SHC-ASTRA/ASTRA_Ground_Station_Electronics/Ground_Station_Electronics/Ground_Station_Electronics.kicad_pcb

## KiCad design Ground_Station_Electronics/Ground_Station_Electronics.kicad_pcb (2022-04-20)

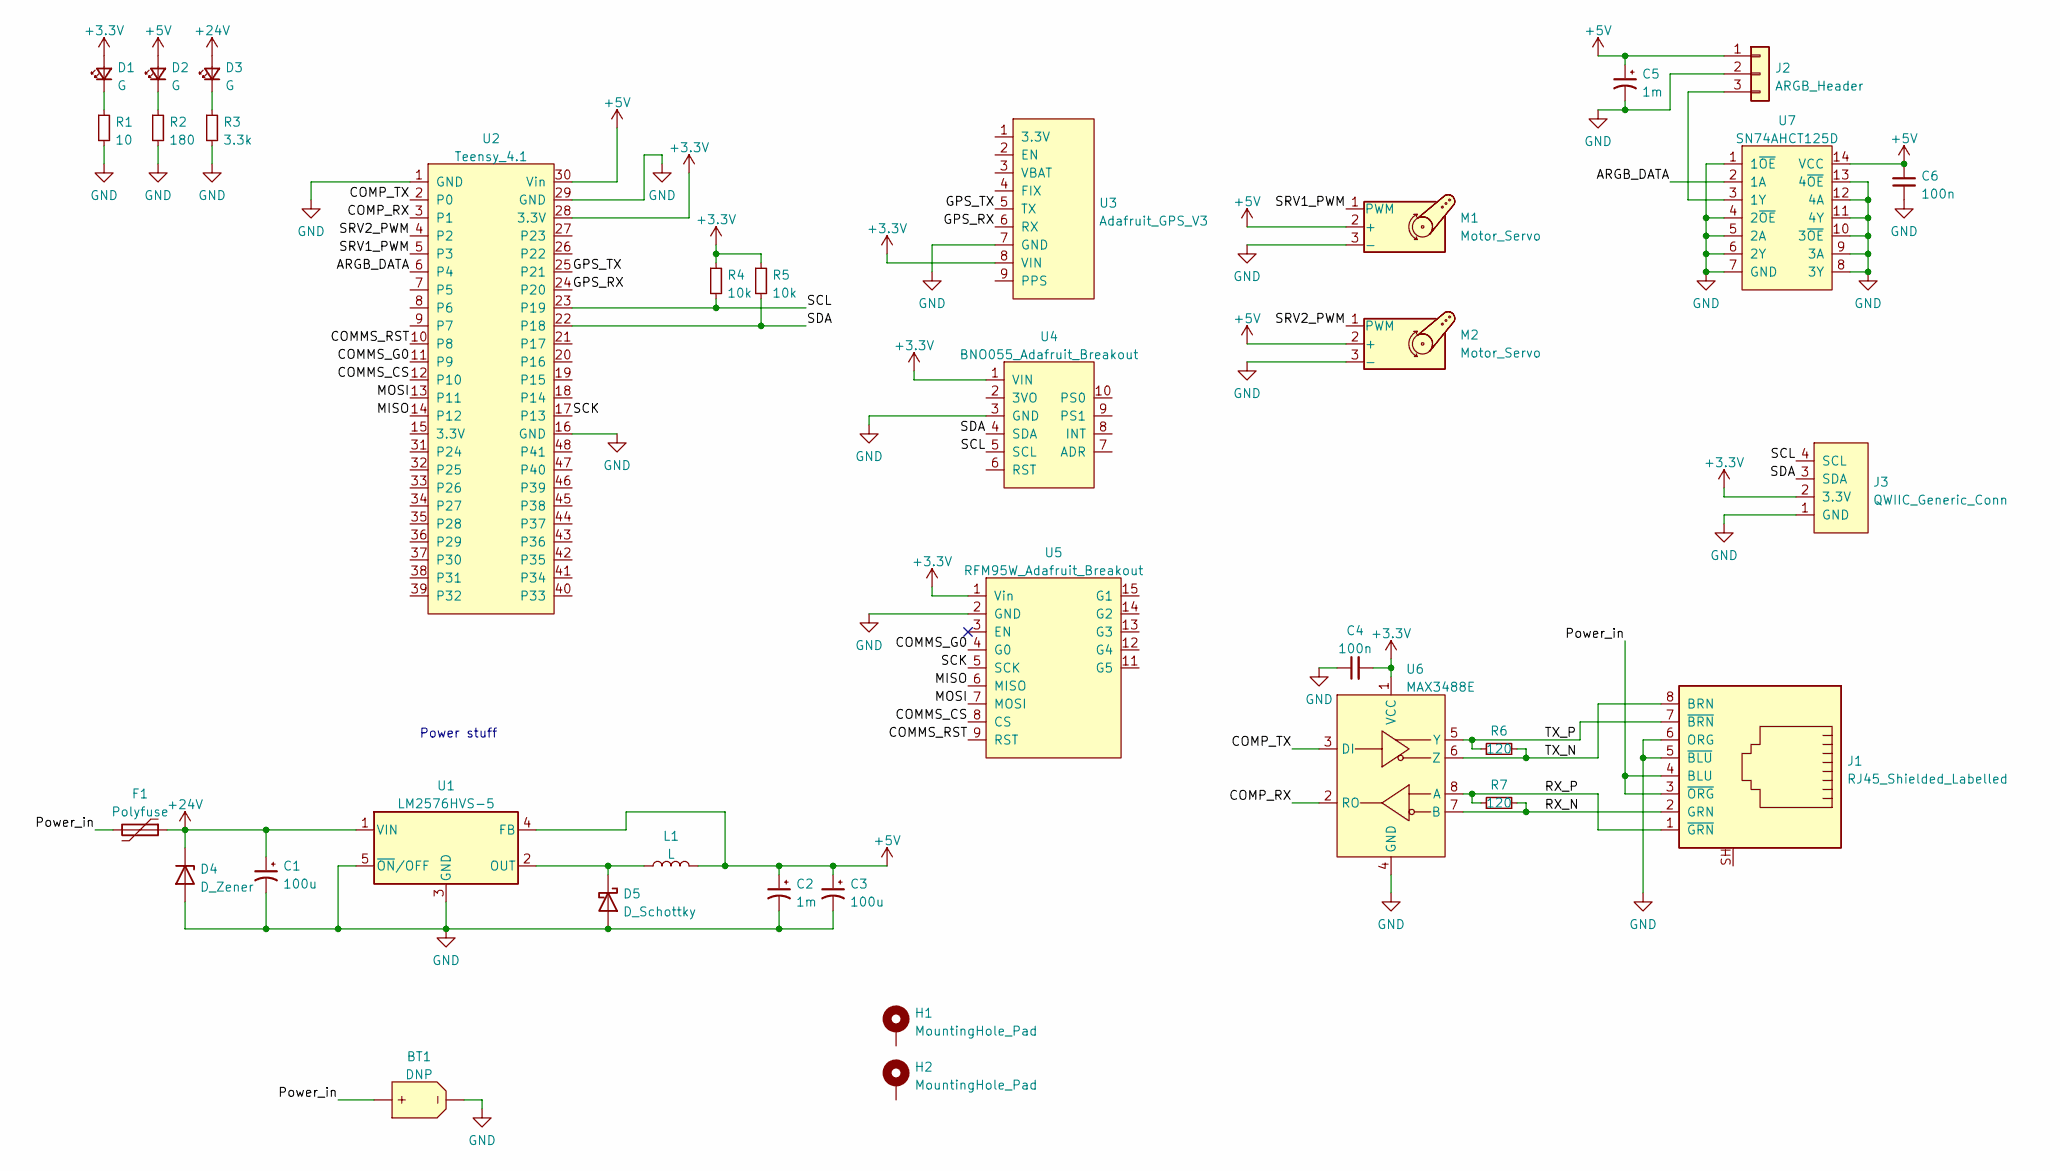
[picture p1: schematic Ground_Station_Electronics.kicad_sch]

Parts:
BT1: DNP; AMASS_XT30U-M_1x02_P5.0mm_Vertical
C1, C3: 100u; CP_Elec_10x10; Digikey Part Num 50PEV100M10X10.5CT-ND
C2, C5: 1m; C_Radial_D10.0mm_H12.5mm_P5.00mm; Digikey Part Num P16300-ND
C4, C6: 100n; C_0603_1608Metric
D1, D2, D3: G; LED_0603_1608Metric_Pad1.05x0.95mm_HandSolder; Digikey Part Num 732-4971-1-ND
D4: D_Zener; D_SMB_Handsoldering; Digikey Part Num 1655-SMBJ36ACT-ND
D5: D_Schottky; D_SMC_Handsoldering; Digikey Part Num B560C-FDICT-ND
F1: Polyfuse; Fuse_2920_7451Metric_Pad2.10x5.45mm_HandSolder; Digikey Part Num 507-1747-1-ND
H1, H2: MountingHole_Pad; MountingHole_4.3mm_M4_Pad
J1: RJ45_Shielded_Labelled; RJ45_Amphenol_RJHSE5380; Digikey Part Num RJHSE5E80-ND
J2: ARGB_Header; JST_PH_B3B-PH-K_1x03_P2.00mm_Vertical
J3: QWIIC_Generic_Conn; JST_SH_BM04B-SRSS-TB_1x04-1MP_P1.00mm_Vertical
L1: L; L_Wuerth_HCF-2920; Digikey Part Num 732-11715-ND
M1, M2: Motor_Servo; PinHeader_1x03_P2.54mm_Vertical
R1: 10; R_0603_1608Metric; Digikey Part Num 311-10.0HRCT-ND
R2: 180; R_0603_1608Metric; Digikey Part Num 311-180HRCT-ND
R3: 3.3k; R_0603_1608Metric; Digikey Part Num 311-3.30KHRCT-ND
R4, R5: 10k; R_0603_1608Metric
R6, R7: 120; R_0603_1608Metric; Digikey Part Num RMCF0603FT120RCT-ND
U1: LM2576HVS-5; TO-263-5_TabPin3; Digikey Part Num LM2576HVS-5.0/NOPB-ND
U2: Teensy_4.1; Teensy4.1; Digikey Part Num 1568-DEV-16996-ND
U3: Adafruit_GPS_V3; Adafruit_GPS_Breakout; Digikey Part Num 1528-1153-ND
U4: BNO055_Adafruit_Breakout; Adafruit_BNO055; Digikey Part Num 1528-4646-ND
U5: RFM95W_Adafruit_Breakout; Adafruit_RFM95W; Digikey Part Num 1528-1667-ND
U6: MAX3488E; SOIC-8_3.9x4.9mm_P1.27mm; Digikey Part Num MAX3488EESA+TCT-ND
U7: SN74AHCT125D; SOIC-14_3.9x8.7mm_P1.27mm; Digikey Part Num 296-4652-5-ND

Connections:
+3V3: C4.2, D1.2 (A), J3.2 (3.3V), R4.1, R5.1, U2.28 (3.3V), U3.8 (VIN), U4.1 (VIN), U5.1 (Vin), U6.1 (VCC)
+5V: C2.1, C3.1, C5.1, C6.2, D2.2 (A), J2.1, L1.2, M1.2 (+), M2.2 (+), U1.4 (FB), U2.30 (Vin), U7.14 (VCC)
+24V: C1.1, D3.2 (A), D4.1 (K), F1.1, U1.1 (VIN)
/ARGB_DATA: U2.6 (P4), U7.2 (1A)
/COMMS_CS: U2.12 (P10), U5.8 (CS)
/COMMS_G0: U2.11 (P9), U5.4 (G0)
/COMMS_RST: U2.10 (P8), U5.9 (RST)
/COMP_RX: U2.3 (P1), U6.2 (RO)
/COMP_TX: U2.2 (P0), U6.3 (DI)
/GPS_RX: U2.24 (P20), U3.6 (RX)
/GPS_TX: U2.25 (P21), U3.5 (TX)
/MISO: U2.14 (P12), U5.6 (MISO)
/MOSI: U2.13 (P11), U5.7 (MOSI)
/Power_in: BT1.2 (Pos), F1.2, J1.3 (~ORG), J1.4 (BLU)
/RX_N: J1.2 (GRN), R7.2, U6.7 (B)
/RX_P: J1.1 (~GRN), R7.1, U6.8 (A)
/SCK: U2.17 (P13), U5.5 (SCK)
/SCL: J3.4 (SCL), R4.2, U2.23 (P19), U4.5 (SCL)
/SDA: J3.3 (SDA), R5.2, U2.22 (P18), U4.4 (SDA)
/SRV1_PWM: M1.1 (PWM), U2.5 (P3)
/SRV2_PWM: M2.1 (PWM), U2.4 (P2)
/TX_N: J1.8 (BRN), R6.2, U6.6 (Z)
/TX_P: J1.7 (~BRN), R6.1, U6.5 (Y)
GND: BT1.1 (Neg), C1.2, C2.2, C3.2, C4.1, C5.2, C6.1, D4.2 (A), D5.2 (A), J1.5 (~BLU), J1.6 (ORG), J2.2, J3.1 (GND), M1.3 (-), M2.3 (-), R1.2, R2.2, R3.2, U1.3 (GND), U1.5 (~ON/OFF), U2.1 (GND), U2.16 (GND), U2.29 (GND), U3.7 (GND), U4.3 (GND), U5.2 (GND), U6.4 (GND), U7.1 (1~OE), U7.4 (2~OE), U7.5 (2A), U7.6 (2Y), U7.7 (GND), U7.8 (3Y), U7.9 (3A), U7.10 (3~OE), U7.11 (4Y), U7.12 (4A), U7.13 (4~OE)
unnamed: D1.1 (K), R1.1
unnamed: D2.1 (K), R2.1
unnamed: D3.1 (K), R3.1
unnamed: D5.1 (K), L1.1, U1.2 (OUT)
unnamed: J2.3, U7.3 (1Y)

Notes on the sheet:
Power stuff

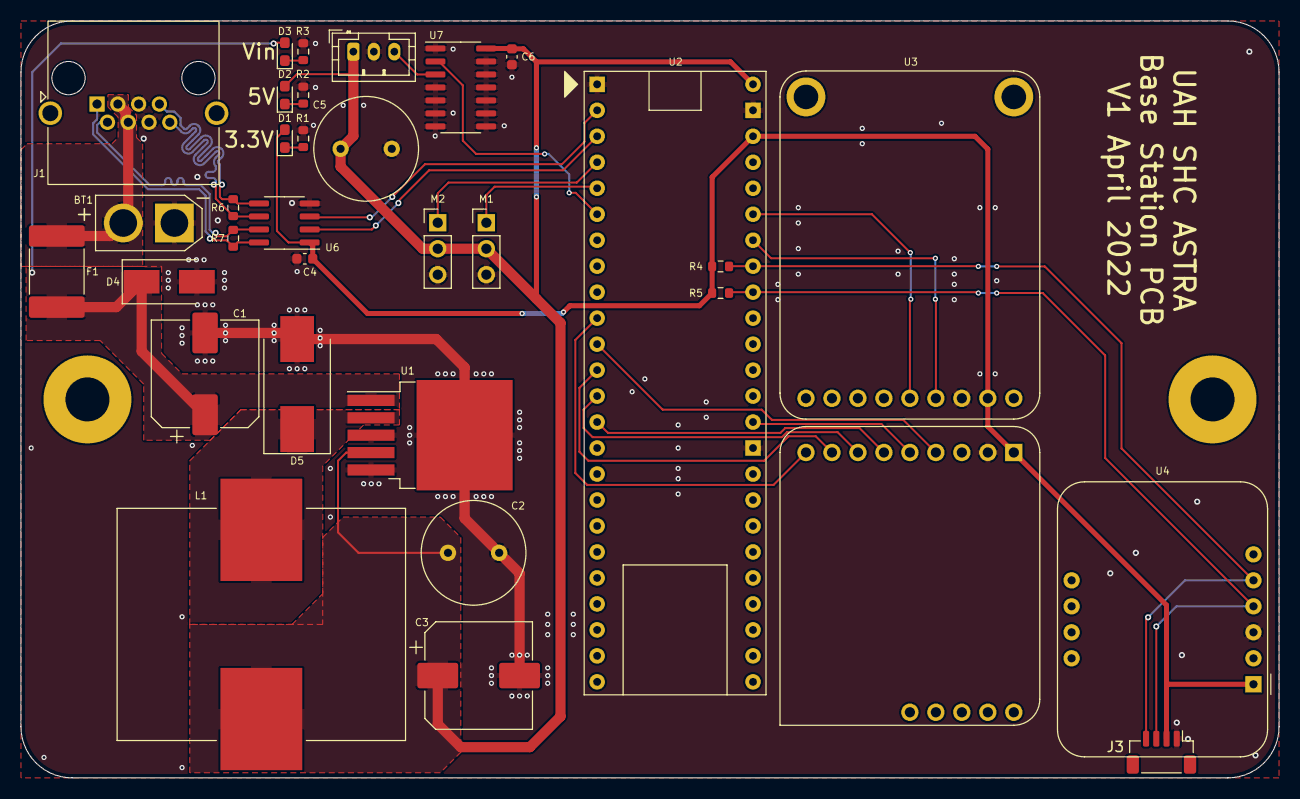
[picture p2: board Ground_Station_Electronics.kicad_pcb from above]

Board: 2 copper layers, 123.0 x 74.0 mm, 35 parts (0 on the bottom side), 29 nets.
