SHC-ASTRA/ASTRA_Ground_Station_Electronics/Ground_Station_Dongle/Ground_Station_Dongle.kicad_pcb

## KiCad design Ground_Station_Dongle/Ground_Station_Dongle.kicad_pcb (2022-04-20)

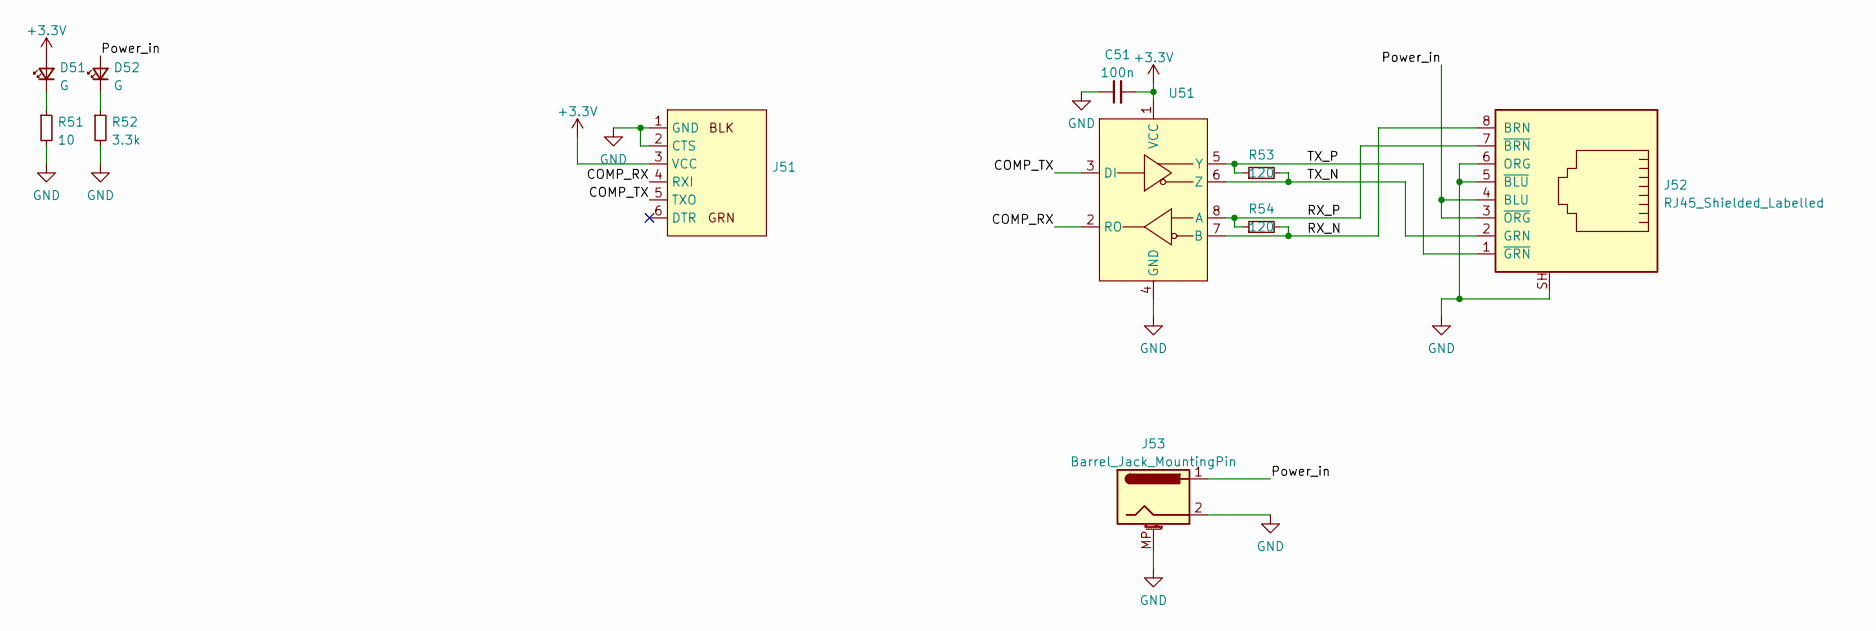
[picture p3: schematic Ground_Station_Dongle.kicad_sch]

Parts:
C51: 100n; C_0603_1608Metric
D51, D52: G; LED_0603_1608Metric_Pad1.05x0.95mm_HandSolder; Digikey Part Num 732-4971-1-ND
J51: (no value)
J52: RJ45_Shielded_Labelled; RJ45_Amphenol_RJHSE5380; Digikey Part Num RJHSE5E80-ND
J53: Barrel_Jack_MountingPin; BarrelJack_CUI_PJ-063AH_Horizontal; Digikey Part Num CP-063AH-ND
R51: 10; R_0603_1608Metric; Digikey Part Num 311-10.0HRCT-ND
R52: 3.3k; R_0603_1608Metric; Digikey Part Num 311-3.30KHRCT-ND
R53, R54: 120; R_0603_1608Metric; Digikey Part Num RMCF0603FT120RCT-ND
U51: Digikey Part Num MAX3488EESA+TCT-ND

Connections:
+3V3: C51.2, D51.2 (A), J51.3 (VCC), U51.1 (VCC)
/COMP_RX: J51.4 (RXI), U51.2 (RO)
/COMP_TX: J51.5 (TXO), U51.3 (DI)
/Power_in: D52.2 (A), J52.3 (~ORG), J52.4 (BLU), J53.1
/RX_N: J52.8 (BRN), R54.2, U51.7 (B)
/RX_P: J52.7 (~BRN), R54.1, U51.8 (A)
/TX_N: J52.2 (GRN), R53.2, U51.6 (Z)
/TX_P: J52.1 (~GRN), R53.1, U51.5 (Y)
GND: C51.1, J51.1 (GND), J51.2 (CTS), J52.5 (~BLU), J52.6 (ORG), J52.SH, J53.2, J53.MP (MountPin), R51.2, R52.2, U51.4 (GND)
unnamed: D51.1 (K), R51.1
unnamed: D52.1 (K), R52.1

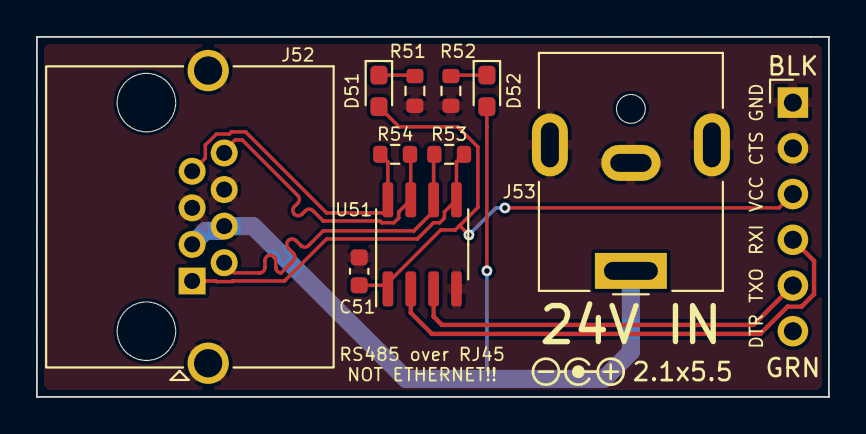
[picture p4: board Ground_Station_Dongle.kicad_pcb from above]

Board: 2 copper layers, 44.0 x 20.0 mm, 11 parts (0 on the bottom side), 11 nets.
