SHC-ASTRA/ASTRA_Ground_Station_Electronics/(commit log)

2022-03-26 Started Schematic
    Not completely finished yet but maybe almost
2022-04-02 Upgraded to KiCAD6, restarted to fix file issues
    [Ground_Station_Electronics.kicad_pcb, Ground_Station_Electronics.kicad_sch, Ground_Station_Electronics.sch]
2022-04-02 worked on rs485
    [Ground_Station_Electronics.kicad_sch]
2022-04-02 Take 2 Electric Boogaloo
    Migrated to KiCad 6.0. Re-added the schematic stuff from last time in the new version, hopefully with working libraries
    [Ground_Station_Electronics.kicad_sch]
2022-04-02 Working on schematic
    [Ground_Station_Electronics.kicad_sch]
2022-04-03 worked on schematic and footprints
    [Ground_Station_Electronics.kicad_sch]
2022-04-03 should be schematic done?
    [Ground_Station_Electronics.kicad_sch]
2022-04-03 started PCB
    [Ground_Station_Electronics.kicad_pcb]
2022-04-03 Forgot to save schematic
    [Ground_Station_Electronics.kicad_sch]
2022-04-03 design rules and grouping
    [Ground_Station_Electronics.kicad_pcb, Ground_Station_Electronics.kicad_sch]
2022-04-03 Layout and routing
    [Ground_Station_Electronics.kicad_pcb, Ground_Station_Electronics.kicad_sch]
2022-04-03 "done" but ugly
    [Ground_Station_Electronics.kicad_pcb, Ground_Station_Electronics.kicad_sch]
2022-04-06 Working on PCB
    [Ground_Station_Electronics.kicad_pcb, Ground_Station_Electronics.kicad_sch]
2022-04-06 schematic save
    [Ground_Station_Electronics.kicad_sch]
2022-04-16 Added Dongle
    [Ground_Station_Dongle.kicad_pcb, Ground_Station_Dongle.kicad_sch, Ground_Station_Electronics.kicad_sch]
2022-04-20 Updated, ready to order
    [Ground_Station_Dongle.kicad_pcb, Ground_Station_Dongle.kicad_sch, Ground_Station_Electronics.kicad_pcb, Ground_Station_Electronics.kicad_sch]
